drfailov/LaserGraver/PC Software/LaserDrawerApp v.3/LaserDrawerApp/png/cartesian-coordinate-system.png

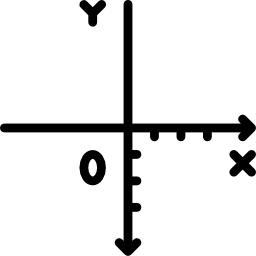
PC Software/LaserDrawerApp v.3/LaserDrawerApp/png/cartesian-coordinate-system.png
