drfailov/LaserGraver/PC Software/LaserDrawerApp v.3/LaserDrawerApp/png/laser.png

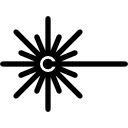
PC Software/LaserDrawerApp v.3/LaserDrawerApp/png/laser.png
