drfailov/LaserGraver/PC Software/LaserDrawerApp v.3/LaserDrawerApp/png/plasma.png

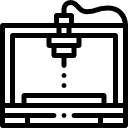
PC Software/LaserDrawerApp v.3/LaserDrawerApp/png/plasma.png
