drfailov/LaserGraver/PC Software/LaserDrawerApp v.3/LaserDrawerApp/png/круги.png

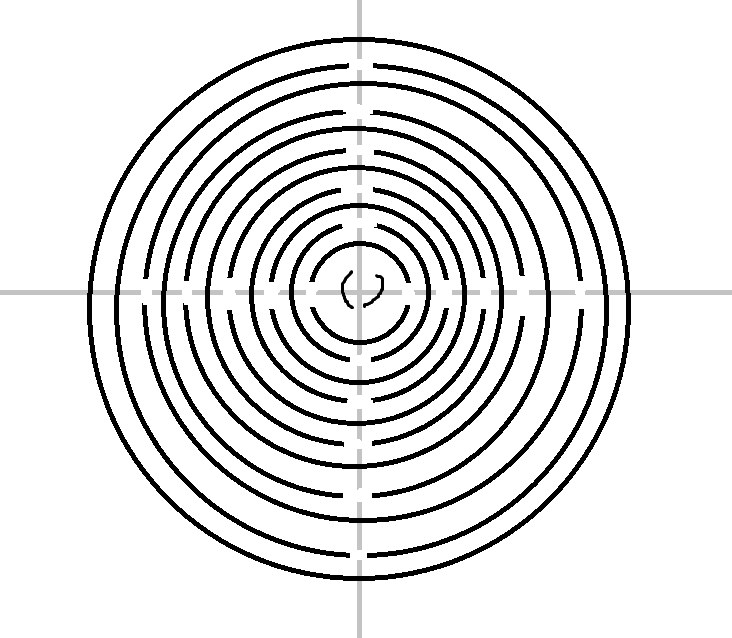
PC Software/LaserDrawerApp v.3/LaserDrawerApp/png/круги.png
