drfailov/LaserGraver/PC Software/LaserDrawerApp v.3/LaserDrawerApp/Resources/5082-512.png

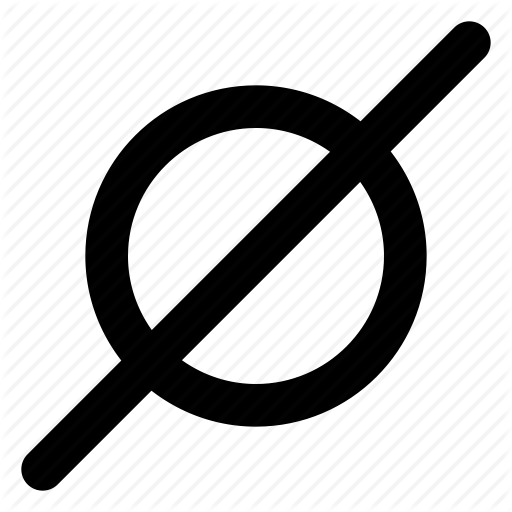
PC Software/LaserDrawerApp v.3/LaserDrawerApp/Resources/5082-512.png
