drfailov/LaserGraver/PC Software/LaserDrawerApp v.3/LaserDrawerApp/Resources/216519.png

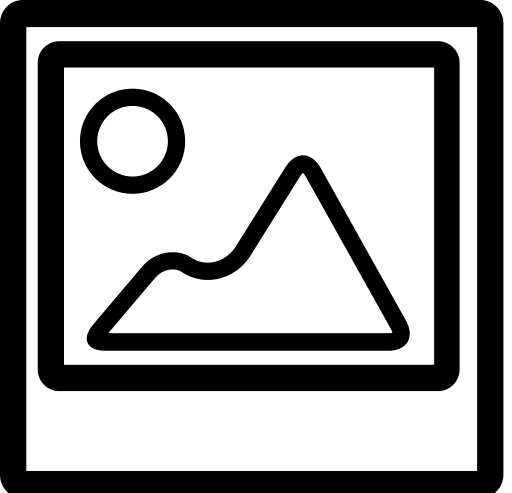
PC Software/LaserDrawerApp v.3/LaserDrawerApp/Resources/216519.png
