drfailov/LaserGraver/PC Software/LaserDrawerApp v.3/LaserDrawerApp/Resources/1415912739_769294410.gif

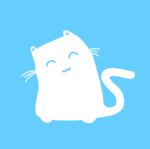
PC Software/LaserDrawerApp v.3/LaserDrawerApp/Resources/1415912739_769294410.gif
