drfailov/LaserGraver/PC Software/LaserDrawerApp v.3/LaserDrawerApp/Resources/1354195812094.gif

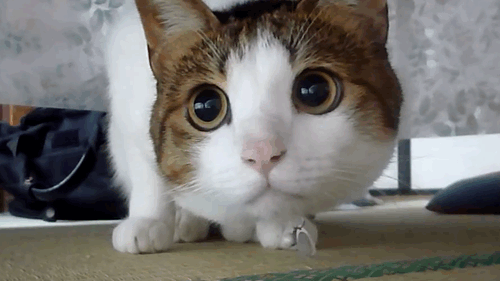
PC Software/LaserDrawerApp v.3/LaserDrawerApp/Resources/1354195812094.gif
