drfailov/LaserGraver/PC Software/LaserDrawerApp v.3/LaserDrawerApp/Resources/Безымянный1.png

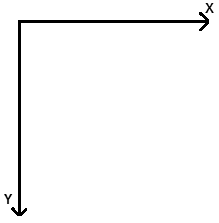
PC Software/LaserDrawerApp v.3/LaserDrawerApp/Resources/Безымянный1.png
