drfailov/LaserGraver/Photos/IMG_20181101_030500.jpg

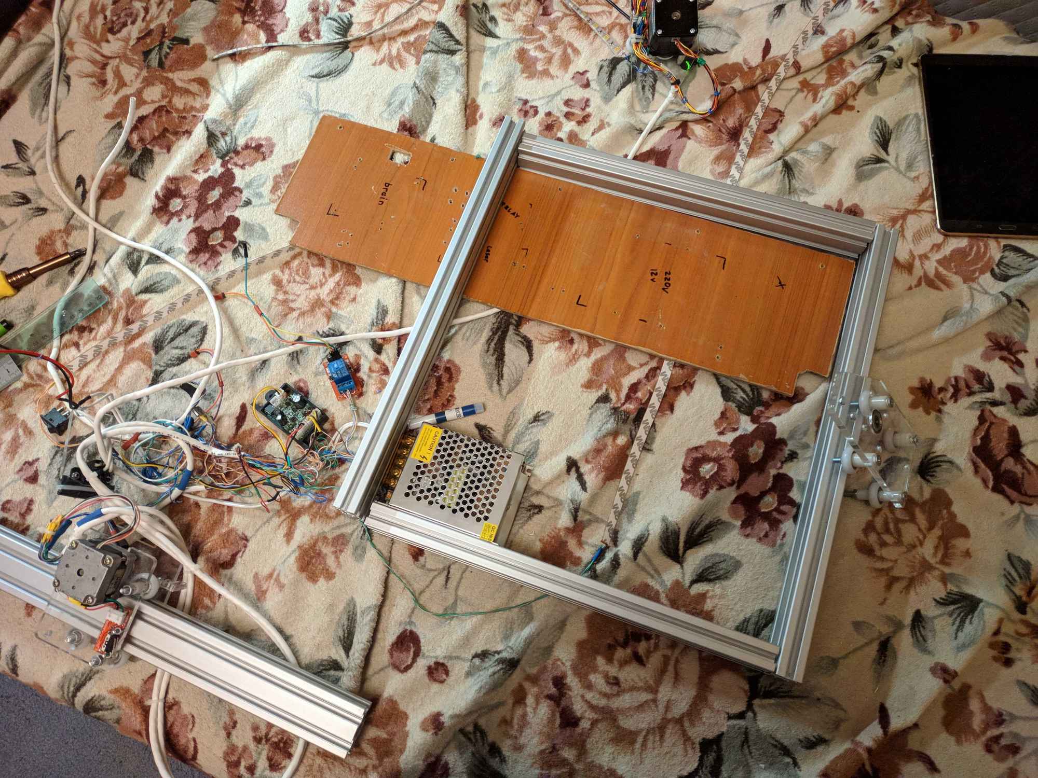
Photos/IMG_20181101_030500.jpg
