drfailov/LaserGraver/Photos/IMG_20210110_220156.jpg

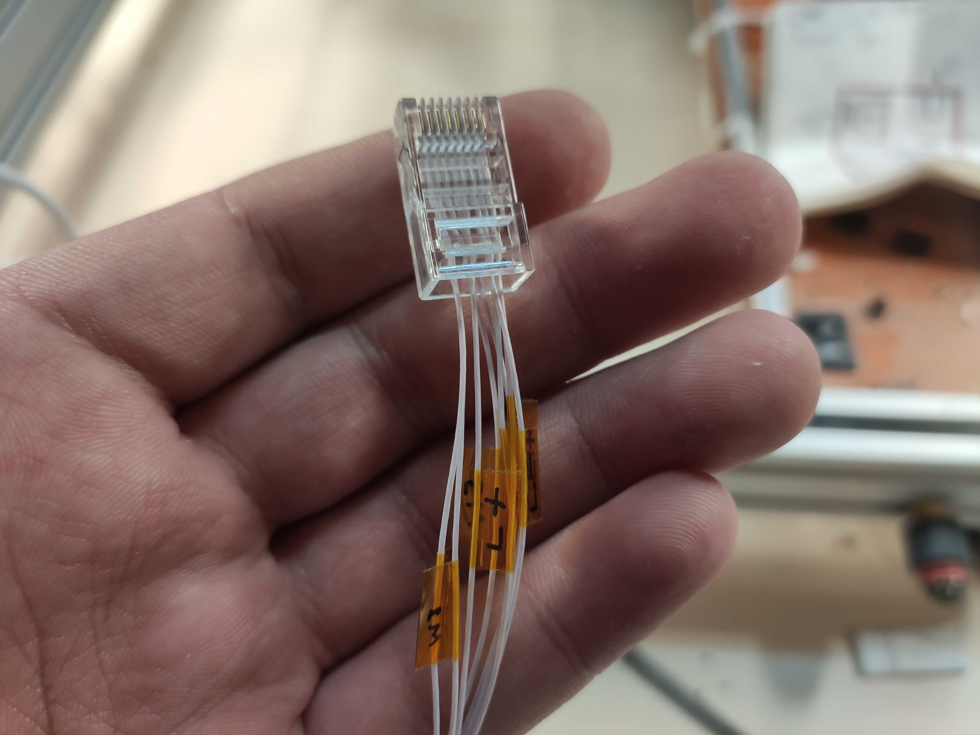
Photos/IMG_20210110_220156.jpg
