drfailov/LaserGraver/Photos/IMG_20210111_155543.jpg

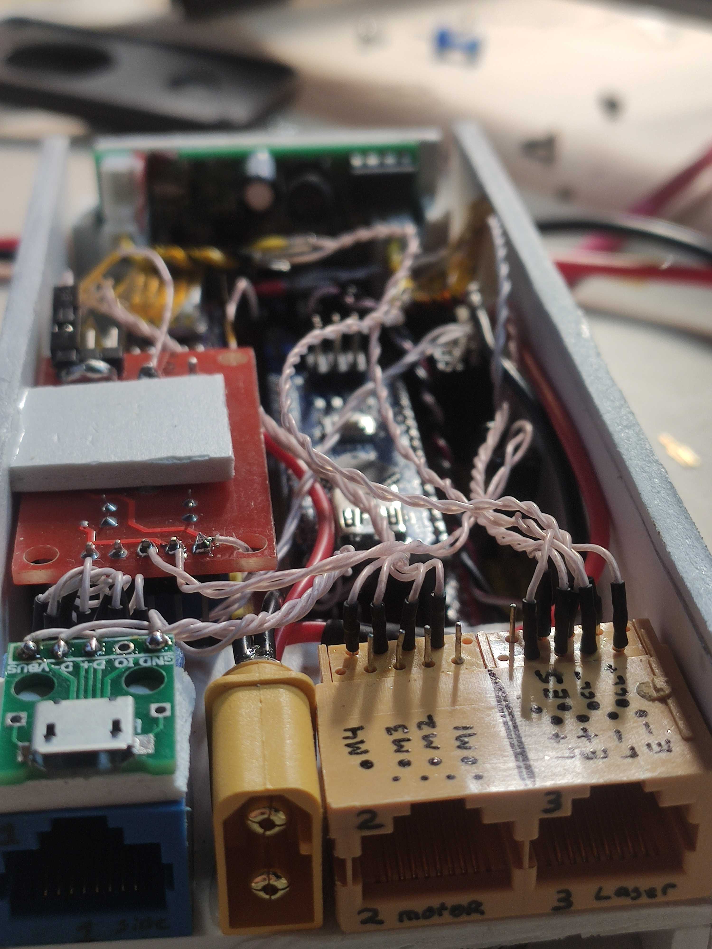
Photos/IMG_20210111_155543.jpg
