drfailov/LaserGraver/Photos/IMG_20210111_155557.jpg

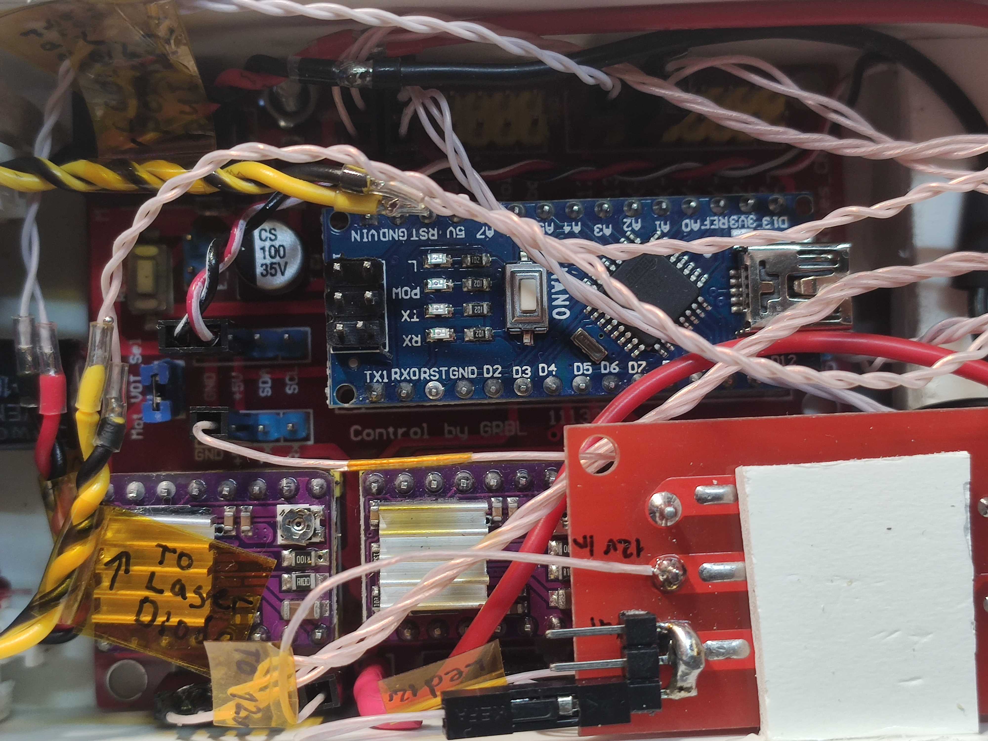
Photos/IMG_20210111_155557.jpg
