drfailov/LaserGraver/Photos/IMG_20210111_162041.jpg

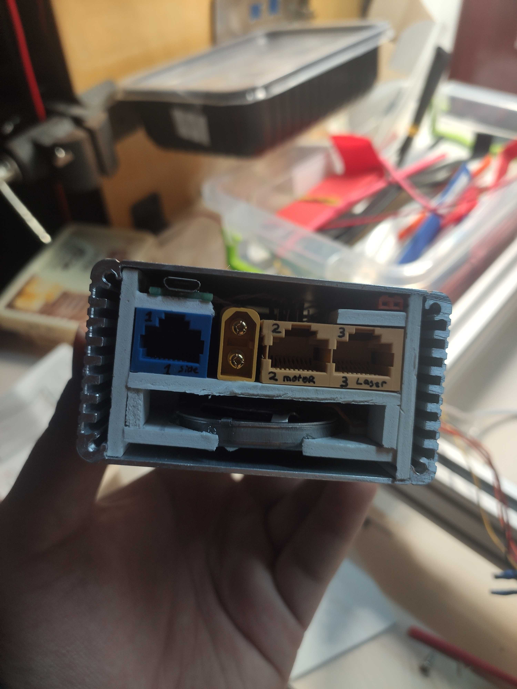
Photos/IMG_20210111_162041.jpg
