drfailov/LaserGraver/Photos/IMG_20210111_175032.jpg

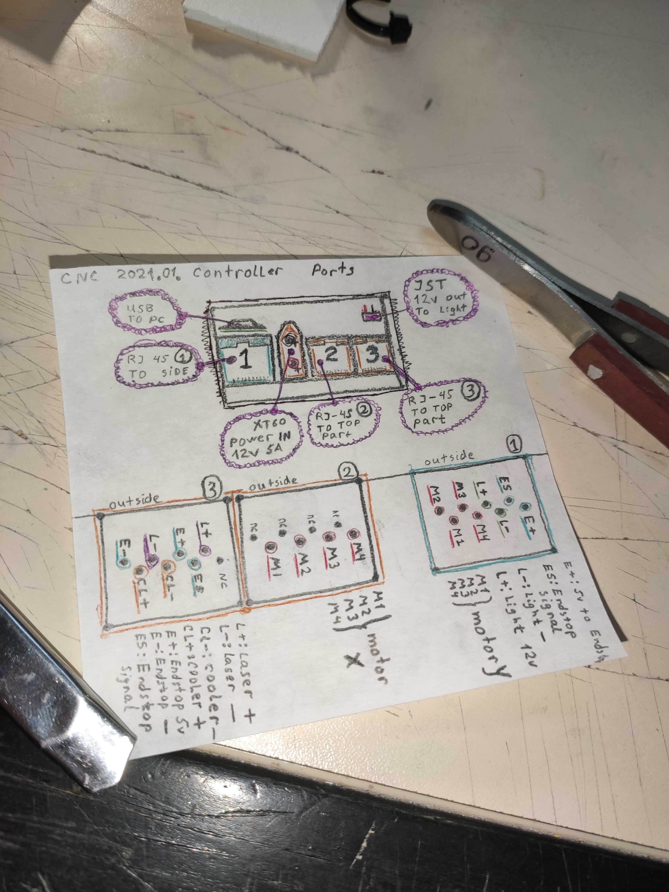
Photos/IMG_20210111_175032.jpg
