drfailov/LaserGraver/Photos/IMG_20210111_175058.jpg

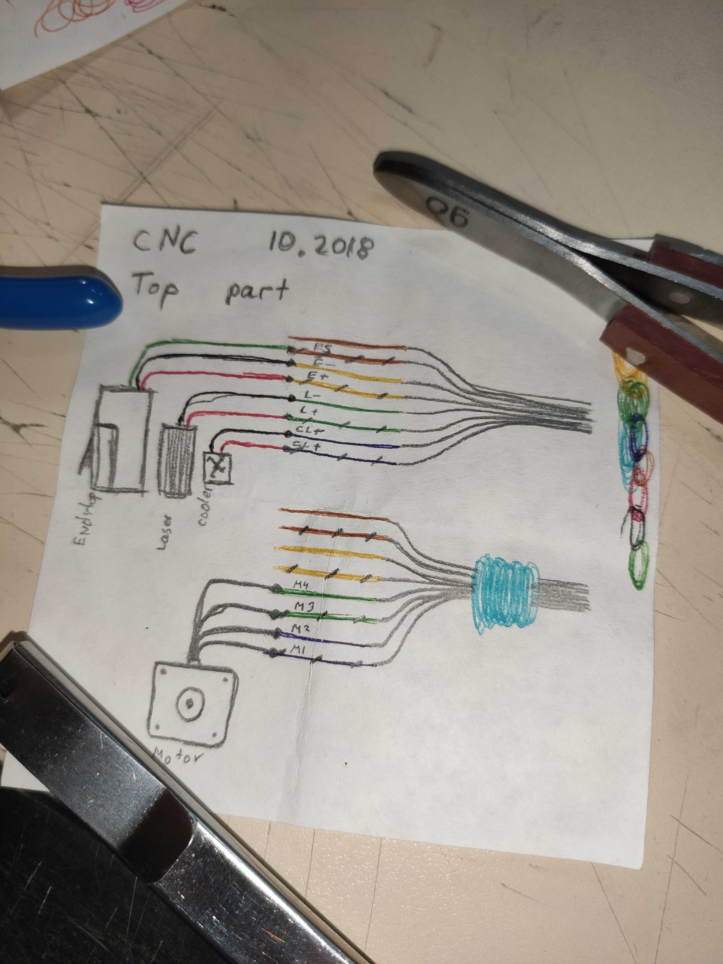
Photos/IMG_20210111_175058.jpg
