drfailov/LaserGraver/Photos/IMG_20210111_175118.jpg

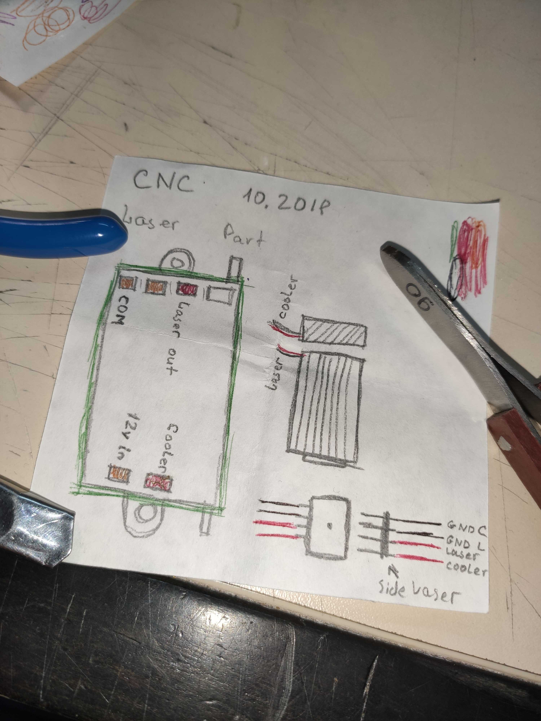
Photos/IMG_20210111_175118.jpg
