drfailov/LaserGraver/Photos/IMG_20210111_175200.jpg

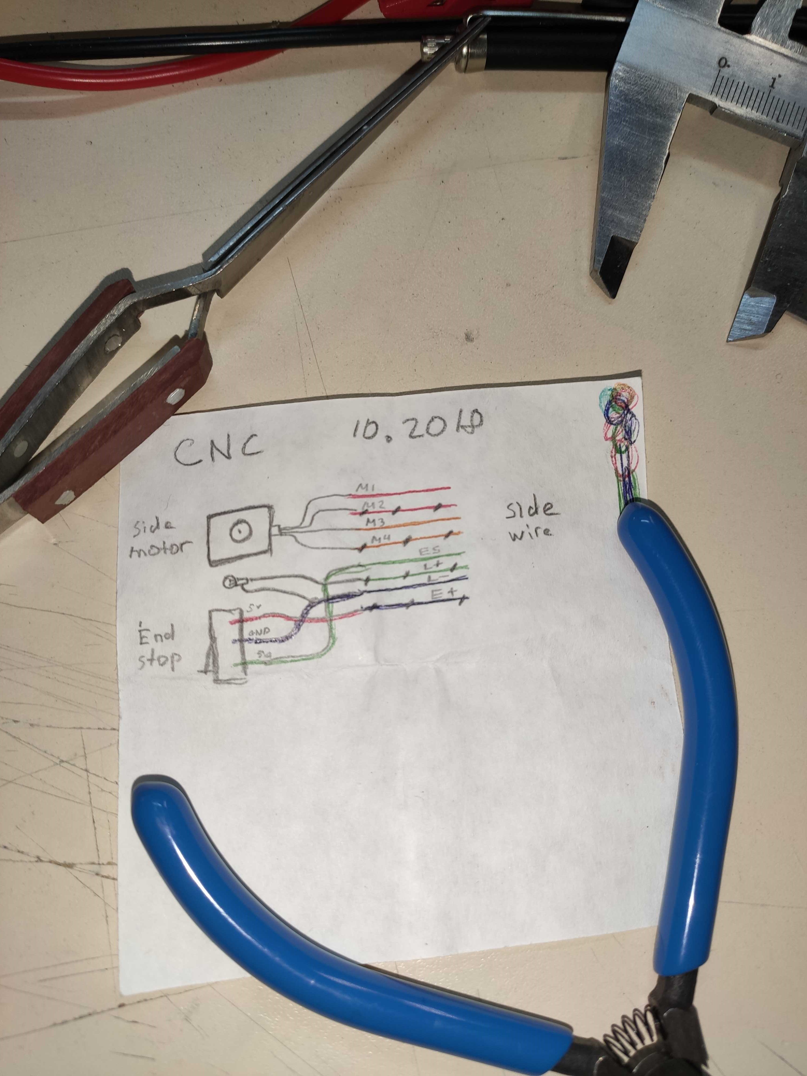
Photos/IMG_20210111_175200.jpg
