drfailov/LaserGraver/Photos/Схема включения.jpg

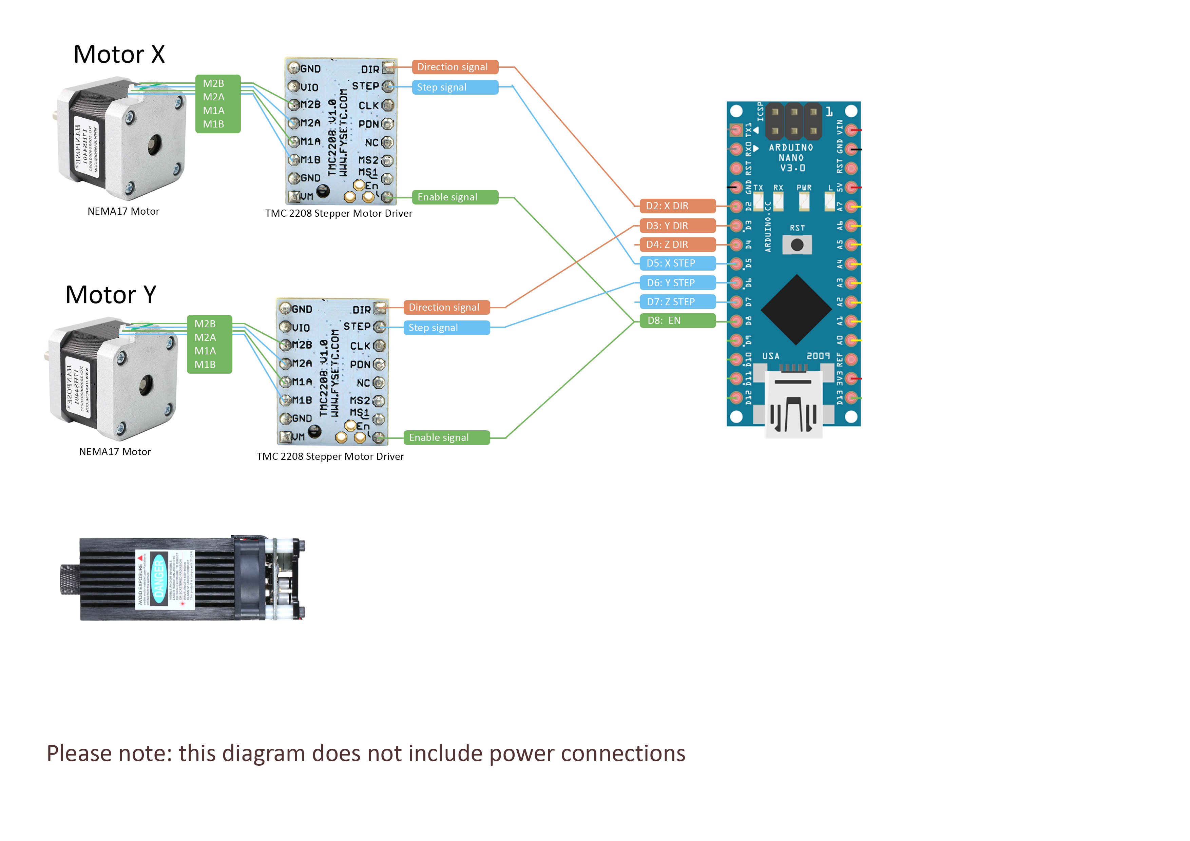
Photos/Схема включения.jpg
