drfailov/LaserGraver/(commit log)

2017-01-27 Fixed constants to match my new engraver
    [Commands.cpp]
2022-03-20 перевод
